RVX/RingoffireCC2DMX/(commit log)

2026-09-29 RingoffireCC2DMX: Teensy 4.1 audio-reactive DMX tremor engine + Reaper JSFX
2026-09-29 Add flash.ps1 one-command Teensy 4.1 flasher
2026-09-29 README: add signal flow, hardware pinout, DMX map, OLED layout diagrams
2026-09-29 Tighter splash, contained NO MIDI banner, USB serial version output
    [ringoffire_CC2DMX.ino]
2026-09-29 Fix splash text overlap: proper 128x32 band spacing
    [ringoffire_CC2DMX.ino]
2026-09-29 v1.1: 128x64 display layout (was wrongly 128x32); spaced splash + main UI
    [ringoffire_CC2DMX.ino]
2026-09-29 Fix gain curve: mid-slider ~1x (was 4x, saturated F1-F4 to max)
    [ringoffire_CC2DMX.ino]
2026-09-29 Fix false NO MIDI: watchdog feeds on any CC; plugin sends CC2 heartbeat
    [ringoffire_CC2DMX.ino]
2026-09-29 README: document current state and known issues (stopping point)
2026-09-29 Add OMR_DMX_TEST hardware test sketch + document A+/B- to XLR wiring
